cwerner77/MicroSpike/PCB/SpikingNeuron/SpikingNeuron.kicad_pcb

## KiCad design PCB/SpikingNeuron/SpikingNeuron.kicad_pcb (2026-11-09)

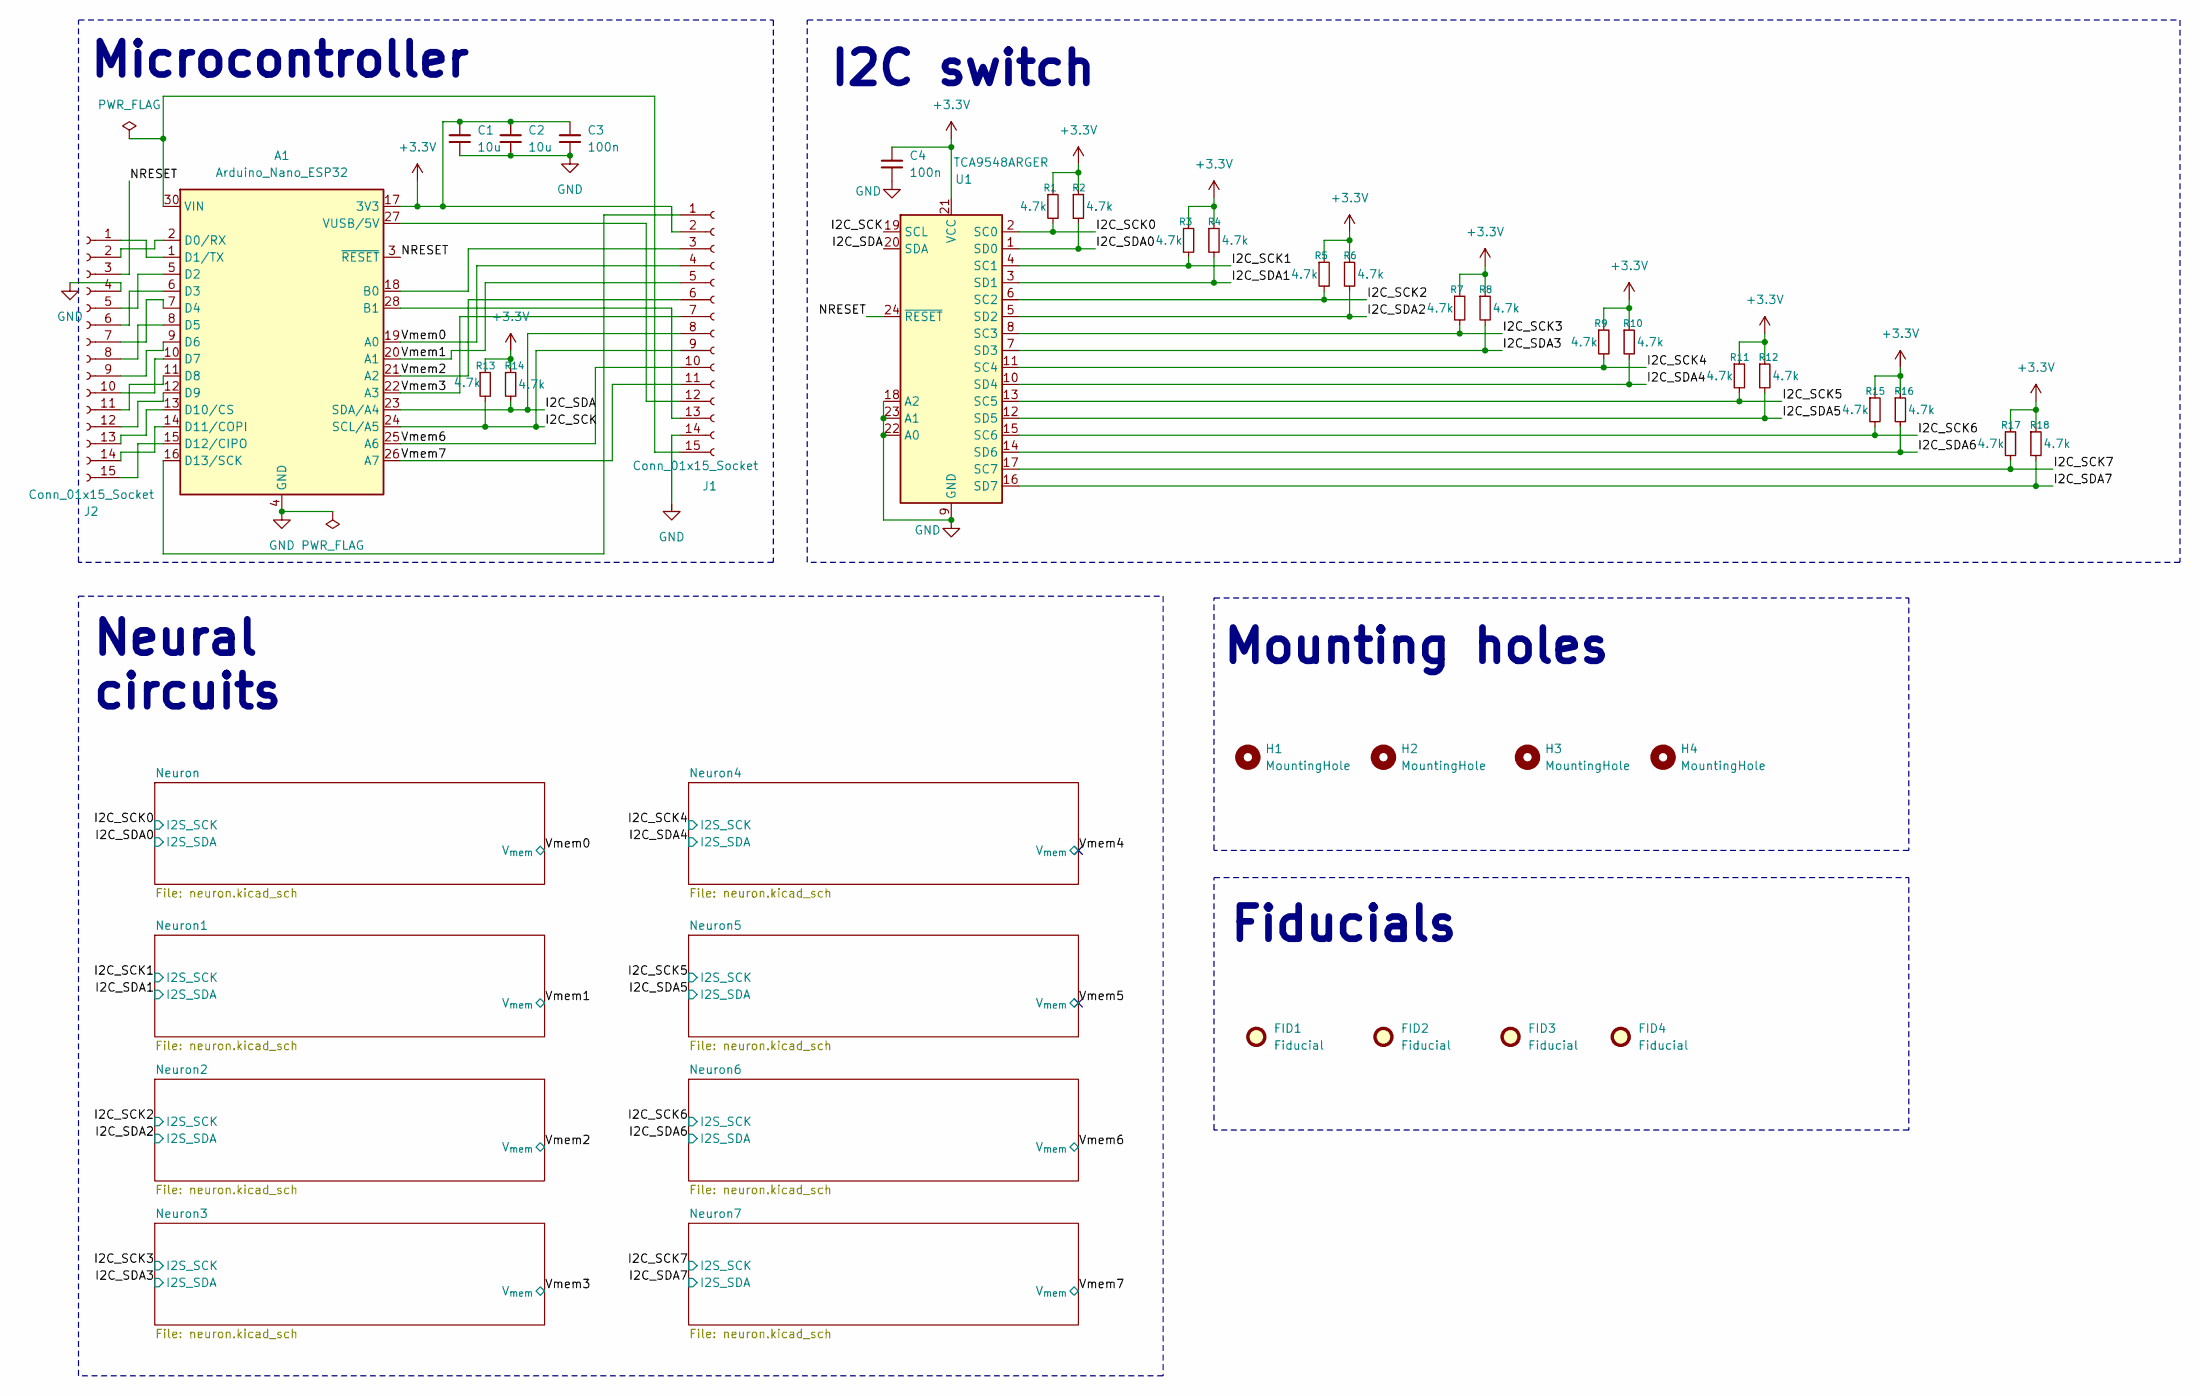
[picture p1: schematic SpikingNeuron.kicad_sch, µSpike]

Parts:
A1: Arduino_Nano_ESP32; Arduino_Nano
C1, C2: 10u; C_0603_1608Metric_Pad1.08x0.95mm_HandSolder
C3, C4: 100n; C_0402_1005Metric_Pad0.74x0.62mm_HandSolder
FID1, FID2, FID3, FID4: Fiducial; Fiducial_0.75mm_Mask1.5mm
H1, H2, H3, H4: MountingHole; MountingHole_3.2mm_M3
J1, J2: Conn_01x15_Socket; PinSocket_1x15_P2.54mm_Vertical
R1, R2, R3, R4, R5, R6, R7, R8, R9, R10, R11, R12, R13, R14, R15, R16, R17, R18: 4.7k; R_0402_1005Metric_Pad0.72x0.64mm_HandSolder
U1: TCA9548ARGER; Texas_RGE0024C_VQFN-24-1EP_4x4mm_P0.5mm_EP2.1x2.1mm

Connections:
+3.3V: A1.17 (3V3), C1.1, C2.1, C3.1, C4.1, J1.2, R1.1, R2.1, R3.1, R4.1, R5.1, R6.1, R7.1, R8.1, R9.1, R10.1, R11.1, R12.1, R13.1, R14.1, R15.1, R16.1, R17.1, R18.1, U1.21 (VCC); also elsewhere on the board
/I2C_SCK: A1.24 (SCL/A5), J1.9, R13.2, U1.19 (SCL)
/I2C_SCK0: R1.2, U1.2 (SC0); also elsewhere on the board
/I2C_SCK1: R3.2, U1.4 (SC1); also elsewhere on the board
/I2C_SCK2: R5.2, U1.6 (SC2); also elsewhere on the board
/I2C_SCK3: R7.2, U1.8 (SC3); also elsewhere on the board
/I2C_SCK4: R9.2, U1.11 (SC4); also elsewhere on the board
/I2C_SCK5: R11.2, U1.13 (SC5); also elsewhere on the board
/I2C_SCK6: R15.2, U1.15 (SC6); also elsewhere on the board
/I2C_SCK7: R17.2, U1.17 (SC7); also elsewhere on the board
/I2C_SDA: A1.23 (SDA/A4), J1.8, R14.2, U1.20 (SDA)
/I2C_SDA0: R2.2, U1.1 (SD0); also elsewhere on the board
/I2C_SDA1: R4.2, U1.3 (SD1); also elsewhere on the board
/I2C_SDA2: R6.2, U1.5 (SD2); also elsewhere on the board
/I2C_SDA3: R8.2, U1.7 (SD3); also elsewhere on the board
/I2C_SDA4: R10.2, U1.10 (SD4); also elsewhere on the board
/I2C_SDA5: R12.2, U1.12 (SD5); also elsewhere on the board
/I2C_SDA6: R16.2, U1.14 (SD6); also elsewhere on the board
/I2C_SDA7: R18.2, U1.16 (SD7); also elsewhere on the board
/NRESET: A1.3 (~RESET), J2.3, U1.24 (~RESET)
/Vmem0: A1.19 (A0), J1.4; also elsewhere on the board
/Vmem1: A1.20 (A1), J1.5; also elsewhere on the board
/Vmem2: A1.21 (A2), J1.6; also elsewhere on the board
/Vmem3: A1.22 (A3), J1.7; also elsewhere on the board
/Vmem6: A1.25 (A6), J1.10; also elsewhere on the board
/Vmem7: A1.26 (A7), J1.11; also elsewhere on the board
GND: A1.4 (GND), A1.29 (GND), C1.2, C2.2, C3.2, C4.2, J1.14, J2.4, U1.9 (GND), U1.18 (A2), U1.22 (A0), U1.23 (A1); also elsewhere on the board
unnamed: A1.18 (B0), J1.3
unnamed: A1.28 (B1), J1.13
unnamed: A1.2 (D0/RX), J2.2
unnamed: A1.1 (D1/TX), J2.1
unnamed: A1.5 (D2), J2.5
unnamed: A1.6 (D3), J2.6
unnamed: A1.7 (D4), J2.7
unnamed: A1.8 (D5), J2.8
unnamed: A1.9 (D6), J2.9
unnamed: A1.10 (D7), J2.10
unnamed: A1.11 (D8), J2.11
unnamed: A1.12 (D9), J2.12
unnamed: A1.13 (D10/CS), J2.13
unnamed: A1.14 (D11/COPI), J2.14
unnamed: A1.15 (D12/CIPO), J2.15
unnamed: A1.16 (D13/SCK), J1.1
unnamed: A1.30 (VIN), J1.15
unnamed: A1.27 (VUSB/5V), J1.12

Notes on the sheet:
I2C switch
Fiducials
Neural circuits
Mounting holes
Microcontroller

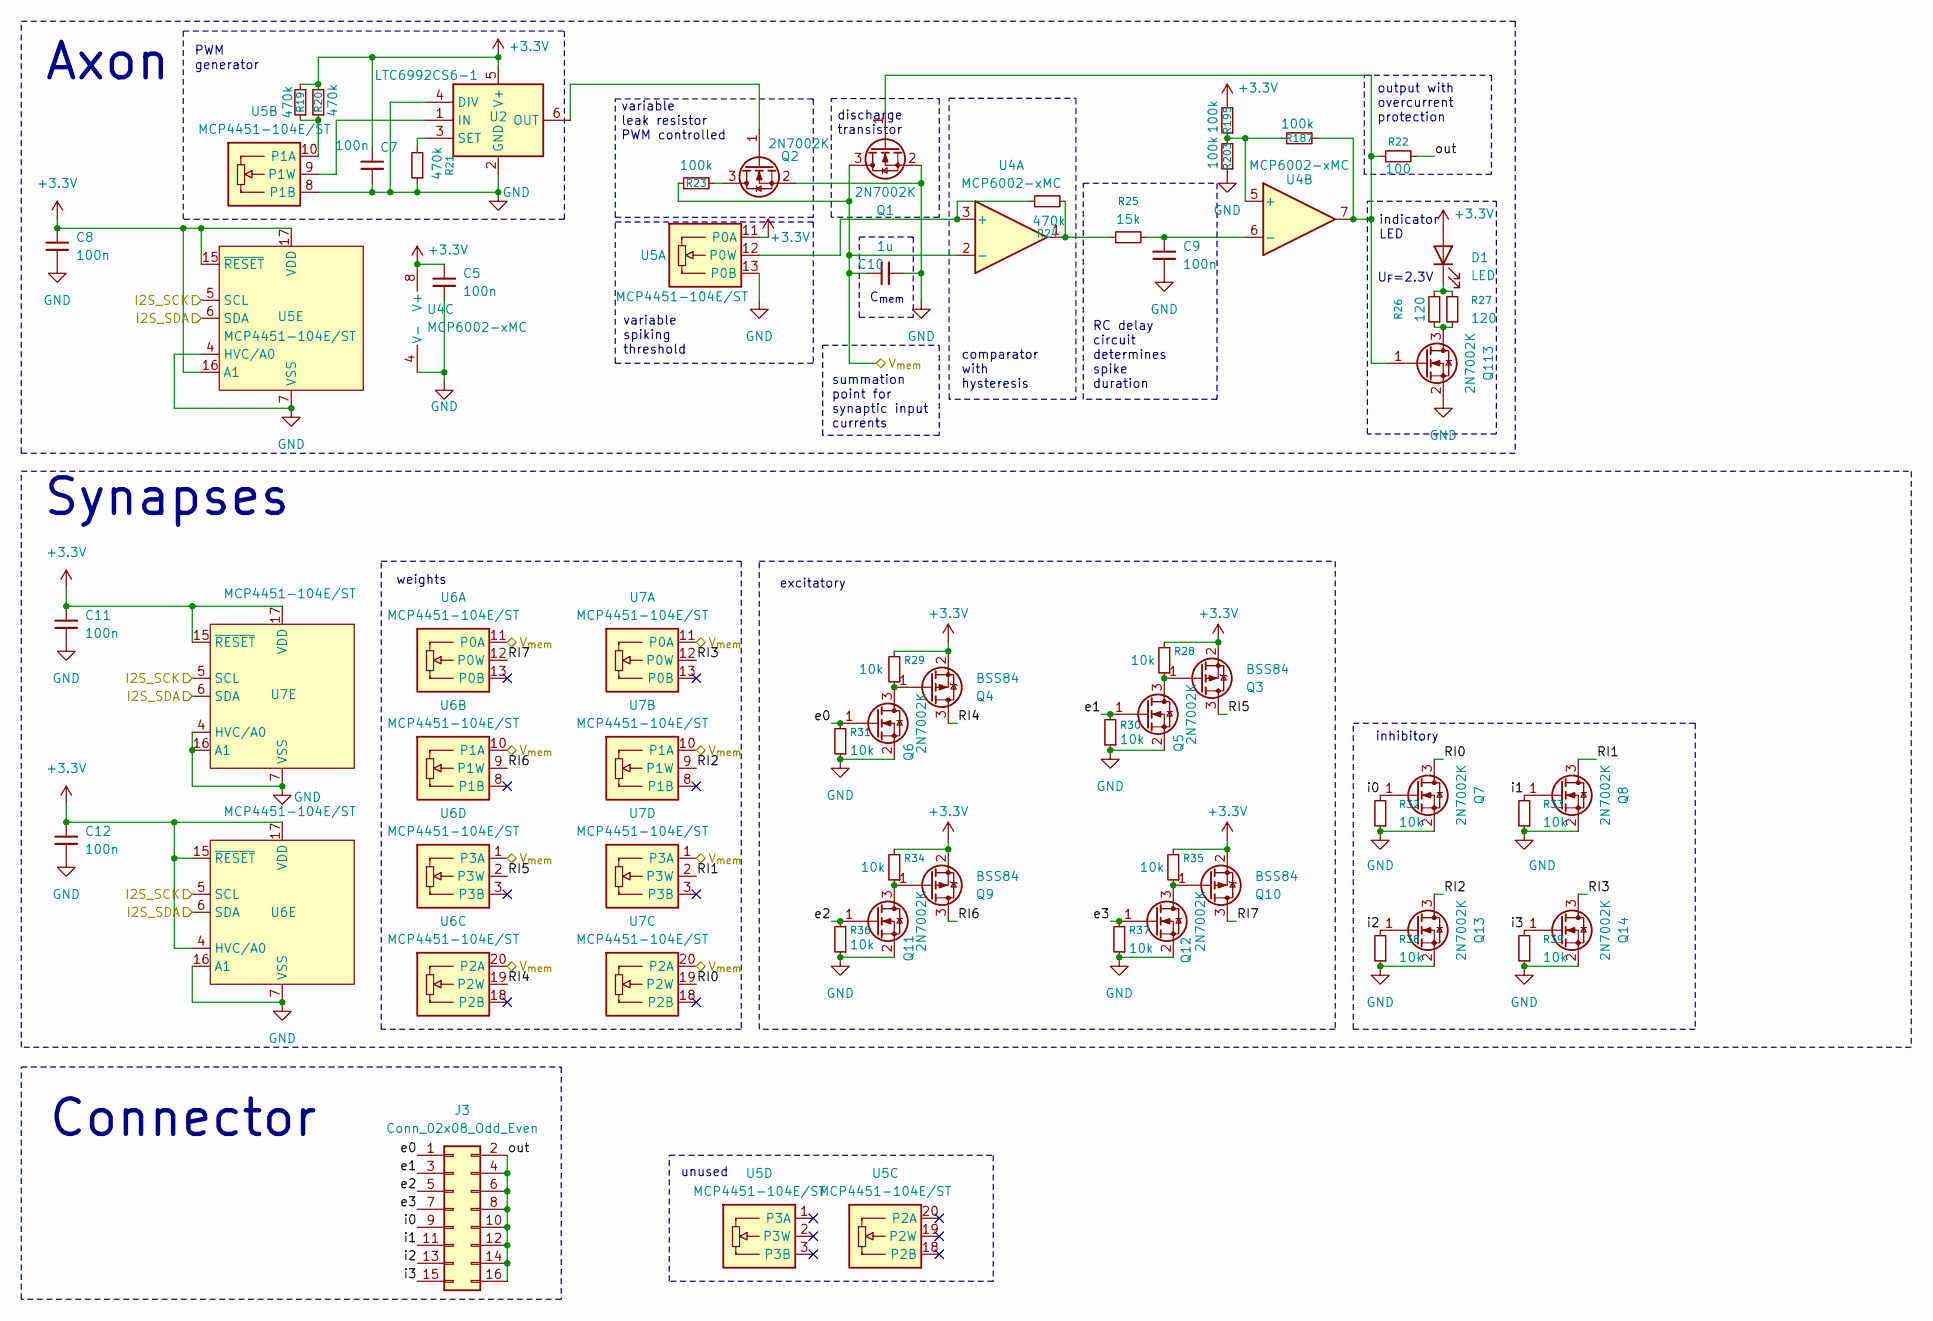
[picture p2: schematic neuron.kicad_sch, µSpike]

Parts:
C5, C7, C8, C9, C11, C12: 100n; C_0402_1005Metric_Pad0.74x0.62mm_HandSolder
C10: 1u; C_0402_1005Metric_Pad0.74x0.62mm_HandSolder
D1: LED; LED_1206_3216Metric_Pad1.42x1.75mm_HandSolder
J3: Conn_02x08_Odd_Even; PinSocket_2x08_P2.54mm_Vertical_SMD
Q1, Q2, Q5, Q6, Q7, Q8, Q11, Q12, Q13, Q14, Q113: 2N7002K; SOT-23
Q3, Q4, Q9, Q10: BSS84; SOT-23
R19, R20, R21, R24: 470k; R_0402_1005Metric_Pad0.72x0.64mm_HandSolder
R22: 100; R_0402_1005Metric_Pad0.72x0.64mm_HandSolder
R23, R187, R195, R203: 100k; R_0402_1005Metric_Pad0.72x0.64mm_HandSolder
R25: 15k; R_0402_1005Metric_Pad0.72x0.64mm_HandSolder
R26, R27: 120; R_0402_1005Metric_Pad0.72x0.64mm_HandSolder
R28, R29, R30, R31, R32, R33, R34, R35, R36, R37, R38, R39: 10k; R_0402_1005Metric_Pad0.72x0.64mm_HandSolder
U2: LTC6992CS6-1; TSOT-23-6
U4: MCP6002-xMC; DFN-8-1EP_3x2mm_P0.5mm_EP1.75x1.45mm
U5, U6, U7: MCP4451-104E/ST; TSSOP-20_4.4x6.5mm_P0.65mm

Connections:
+3.3V: C5.1, C7.1, C8.1, C11.1, C12.1, D1.2 (A), Q3.2 (S), Q4.2 (S), Q9.2 (S), Q10.2 (S), R19.2, R20.2, R28.2, R29.2, R34.2, R35.2, R195.2, U2.5 (V+), U4.8 (V+), U5.11 (P0A), U5.15 (~RESET), U5.16 (A1), U5.17 (VDD), U6.4 (HVC/A0), U6.15 (~RESET), U6.17 (VDD), U7.15 (~RESET), U7.17 (VDD); also elsewhere on the board
/I2C_SCK0: U5.5 (SCL), U6.5 (SCL), U7.5 (SCL); also elsewhere on the board
/I2C_SDA0: U5.6 (SDA), U6.6 (SDA), U7.6 (SDA); also elsewhere on the board
/Neuron/RI0: Q7.3 (D), U7.19 (P2W)
/Neuron/RI1: Q8.3 (D), U7.2 (P3W)
/Neuron/RI2: Q13.3 (D), U7.9 (P1W)
/Neuron/RI3: Q14.3 (D), U7.12 (P0W)
/Neuron/RI4: Q4.3 (D), U6.19 (P2W)
/Neuron/RI5: Q3.3 (D), U6.2 (P3W)
/Neuron/RI6: Q9.3 (D), U6.9 (P1W)
/Neuron/RI7: Q10.3 (D), U6.12 (P0W)
/Neuron/e0: J3.1, Q6.1 (G), R31.2
/Neuron/e1: J3.3, Q5.1 (G), R30.2
/Neuron/e2: J3.5, Q11.1 (G), R36.2
/Neuron/e3: J3.7, Q12.1 (G), R37.2
/Neuron/i0: J3.9, Q7.1 (G), R32.2
/Neuron/i1: J3.11, Q8.1 (G), R33.2
/Neuron/i2: J3.13, Q13.1 (G), R38.2
/Neuron/i3: J3.15, Q14.1 (G), R39.2
/Neuron/out: J3.2, J3.4, J3.6, J3.8, J3.10, J3.12, J3.14, J3.16, R22.2
/Vmem0: C10.1, Q1.3 (D), R23.1, U4.2 (-), U6.1 (P3A), U6.10 (P1A), U6.11 (P0A), U6.20 (P2A), U7.1 (P3A), U7.10 (P1A), U7.11 (P0A), U7.20 (P2A); also elsewhere on the board
GND: C5.2, C7.2, C8.2, C9.1, C10.2, C11.2, C12.2, Q1.2 (S), Q2.2 (S), Q5.2 (S), Q6.2 (S), Q7.2 (S), Q8.2 (S), Q11.2 (S), Q12.2 (S), Q13.2 (S), Q14.2 (S), Q113.2 (S), R21.1, R30.1, R31.1, R32.1, R33.1, R36.1, R37.1, R38.1, R39.1, R203.1, U2.2 (GND), U2.4 (DIV), U4.4 (V-), U4.9 (V-), U5.4 (HVC/A0), U5.7 (VSS), U5.8 (P1B), U5.13 (P0B), U6.7 (VSS), U6.16 (A1), U7.4 (HVC/A0), U7.7 (VSS), U7.16 (A1); also elsewhere on the board
unnamed: D1.1 (K), R26.2, R27.2
unnamed: Q1.1 (G), Q113.1 (G), R22.1, R187.2, U4.7
unnamed: Q2.3 (D), R23.2
unnamed: Q2.1 (G), U2.6 (OUT)
unnamed: Q3.1 (G), Q5.3 (D), R28.1
unnamed: Q4.1 (G), Q6.3 (D), R29.1
unnamed: Q10.1 (G), Q12.3 (D), R35.1
unnamed: Q9.1 (G), Q11.3 (D), R34.1
unnamed: Q113.3 (D), R26.1, R27.1
unnamed: R24.2, R25.1, U4.1
unnamed: U2.1 (IN), U5.9 (P1W)
unnamed: R21.2, U2.3 (SET)
unnamed: R24.1, U4.3 (+), U5.12 (P0W)
unnamed: R187.1, R195.1, R203.2, U4.5 (+)
unnamed: C9.2, R25.2, U4.6 (-)
unnamed: R19.1, R20.1, U5.10 (P1A)

Parts of its further copies:
C13, C15, C16, C17, C19, C20, C21, C23, C24, C25, C27, C28, C29, C31, C32, C33, C35, C36, C37, C39, C40, C41, C43, C44, C45, C47, C48, C49, C51, C52, C53, C55, C56, C57, C59, C60, C61, C63, C64, C65, C67, C68: 100n; C_0402_1005Metric_Pad0.74x0.62mm_HandSolder
C18, C26, C34, C42, C50, C58, C66: 1u; C_0402_1005Metric_Pad0.74x0.62mm_HandSolder
D2, D3, D4, D5, D6, D7, D8: LED; LED_1206_3216Metric_Pad1.42x1.75mm_HandSolder
J4, J5, J6, J7, J8, J9, J10: Conn_02x08_Odd_Even; PinSocket_2x08_P2.54mm_Vertical_SMD
Q15, Q16, Q19, Q20, Q21, Q22, Q25, Q26, Q27, Q28, Q29, Q30, Q33, Q34, Q35, Q36, Q39, Q40, Q41, Q42, Q43, Q44, Q47, Q48, Q49, Q50, Q53, Q54, Q55, Q56, Q57, Q58, Q61, Q62, Q63, Q64, Q67, Q68, Q69, Q70, Q71, Q72, Q75, Q76, Q77, Q78, Q81, Q82, Q83, Q84, Q85, Q86, Q89, Q90, Q91, Q92, Q95, Q96, Q97, Q98, Q99, Q100, Q103, Q104, Q105, Q106, Q109, Q110, Q111, Q112, Q114, Q115, Q116, Q117, Q118, Q119, Q120: 2N7002K; SOT-23
Q17, Q18, Q23, Q24, Q31, Q32, Q37, Q38, Q45, Q46, Q51, Q52, Q59, Q60, Q65, Q66, Q73, Q74, Q79, Q80, Q87, Q88, Q93, Q94, Q101, Q102, Q107, Q108: BSS84; SOT-23
R40, R41, R42, R45, R61, R62, R63, R66, R82, R83, R84, R87, R103, R104, R105, R108, R124, R125, R126, R129, R145, R146, R147, R150, R166, R167, R168, R171: 470k; R_0402_1005Metric_Pad0.72x0.64mm_HandSolder
R43, R64, R85, R106, R127, R148, R169: 100; R_0402_1005Metric_Pad0.72x0.64mm_HandSolder
R44, R65, R86, R107, R128, R149, R170, R188, R189, R190, R191, R192, R193, R194, R196, R197, R198, R199, R200, R201, R202, R204, R205, R206, R207, R208, R209, R210: 100k; R_0402_1005Metric_Pad0.72x0.64mm_HandSolder
R46, R67, R88, R109, R130, R151, R172: 15k; R_0402_1005Metric_Pad0.72x0.64mm_HandSolder
R47, R48, R68, R69, R89, R90, R110, R111, R131, R132, R152, R153, R173, R174: 120; R_0402_1005Metric_Pad0.72x0.64mm_HandSolder
R49, R50, R51, R52, R53, R54, R55, R56, R57, R58, R59, R60, R70, R71, R72, R73, R74, R75, R76, R77, R78, R79, R80, R81, R91, R92, R93, R94, R95, R96, R97, R98, R99, R100, R101, R102, R112, R113, R114, R115, R116, R117, R118, R119, R120, R121, R122, R123, R133, R134, R135, R136, R137, R138, R139, R140, R141, R142, R143, R144, R154, R155, R156, R157, R158, R159, R160, R161, R162, R163, R164, R165, R175, R176, R177, R178, R179, R180, R181, R182, R183, R184, R185, R186: 10k; R_0402_1005Metric_Pad0.72x0.64mm_HandSolder
U8, U15, U22, U29, U36, U43, U50: LTC6992CS6-1; TSOT-23-6
U10, U17, U24, U31, U38, U45, U52: MCP6002-xMC; DFN-8-1EP_3x2mm_P0.5mm_EP1.75x1.45mm
U11, U12, U13, U14, U18, U19, U20, U21, U25, U26, U27, U28, U32, U34, U35, U41, U42, U48, U49, U55, U56: MCP4451-104E/ST; TSSOP-20_4.4x6.5mm_P0.65mm

Connections of its further copies:
+3.3V: C13.1, C15.1, C16.1, C19.1, C20.1, C21.1, C23.1, C24.1, C27.1, C28.1, C29.1, C31.1, C32.1, C35.1, C36.1, C37.1, C39.1, C40.1, C43.1, C44.1, C45.1, C47.1, C48.1, C51.1, C52.1, C53.1, C55.1, C56.1, C59.1, C60.1, C61.1, C63.1, C64.1, C67.1, C68.1, D2.2 (A), D3.2 (A), D4.2 (A), D5.2 (A), D6.2 (A), D7.2 (A), D8.2 (A), Q17.2 (S), Q18.2 (S), Q23.2 (S), Q24.2 (S), Q31.2 (S), Q32.2 (S), Q37.2 (S), Q38.2 (S), Q45.2 (S), Q46.2 (S), Q51.2 (S), Q52.2 (S), Q59.2 (S), Q60.2 (S), Q65.2 (S), Q66.2 (S), Q73.2 (S), Q74.2 (S), Q79.2 (S), Q80.2 (S), Q87.2 (S), Q88.2 (S), Q93.2 (S), Q94.2 (S), Q101.2 (S), Q102.2 (S), Q107.2 (S), Q108.2 (S), R40.2, R41.2, R49.2, R50.2, R55.2, R56.2, R61.2, R62.2, R70.2, R71.2, R76.2, R77.2, R82.2, R83.2, R91.2, R92.2, R97.2, R98.2, R103.2, R104.2, R112.2, R113.2, R118.2, R119.2, R124.2, R125.2, R133.2, R134.2, R139.2, R140.2, R145.2, R146.2, R154.2, R155.2, R160.2, R161.2, R166.2, R167.2, R175.2, R176.2, R181.2, R182.2, R196.2, R197.2, R198.2, R199.2, R200.2, R201.2, R202.2, U8.5 (V+), U10.8 (V+), U11.11 (P0A), U11.15 (~RESET), U11.16 (A1), U11.17 (VDD), U12.11 (P0A), U12.15 (~RESET), U12.16 (A1), U12.17 (VDD), U13.4 (HVC/A0), U13.15 (~RESET), U13.17 (VDD), U14.15 (~RESET), U14.17 (VDD), U15.5 (V+), U17.8 (V+), U18.11 (P0A), U18.15 (~RESET), U18.16 (A1), U18.17 (VDD), U19.11 (P0A), U19.15 (~RESET), U19.16 (A1), U19.17 (VDD), U20.4 (HVC/A0), U20.15 (~RESET), U20.17 (VDD), U21.15 (~RESET), U21.17 (VDD), U22.5 (V+), U24.8 (V+), U25.11 (P0A), U25.15 (~RESET), U25.16 (A1), U25.17 (VDD), U26.11 (P0A), U26.15 (~RESET), U26.16 (A1), U26.17 (VDD), U27.4 (HVC/A0), U27.15 (~RESET), U27.17 (VDD), U28.15 (~RESET), U28.17 (VDD), U29.5 (V+), U31.8 (V+), U32.11 (P0A), U32.15 (~RESET), U32.16 (A1), U32.17 (VDD), U34.4 (HVC/A0), U34.15 (~RESET), U34.17 (VDD), U35.15 (~RESET), U35.17 (VDD), U36.5 (V+), U38.8 (V+), U41.4 (HVC/A0), U41.15 (~RESET), U41.17 (VDD), U42.15 (~RESET), U42.17 (VDD), U43.5 (V+), U45.8 (V+), U48.4 (HVC/A0), U48.15 (~RESET), U48.17 (VDD), U49.15 (~RESET), U49.17 (VDD), U50.5 (V+), U52.8 (V+), U55.4 (HVC/A0), U55.15 (~RESET), U55.17 (VDD), U56.15 (~RESET), U56.17 (VDD); also elsewhere on the board
/I2C_SCK1: U11.5 (SCL), U13.5 (SCL), U14.5 (SCL); also elsewhere on the board
/I2C_SCK2: U12.5 (SCL), U20.5 (SCL), U21.5 (SCL); also elsewhere on the board
/I2C_SCK3: U18.5 (SCL), U27.5 (SCL), U28.5 (SCL); also elsewhere on the board
/I2C_SCK4: U19.5 (SCL), U34.5 (SCL), U35.5 (SCL); also elsewhere on the board
/I2C_SCK5: U25.5 (SCL), U41.5 (SCL), U42.5 (SCL); also elsewhere on the board
/I2C_SCK6: U26.5 (SCL), U48.5 (SCL), U49.5 (SCL); also elsewhere on the board
/I2C_SCK7: U32.5 (SCL), U55.5 (SCL), U56.5 (SCL); also elsewhere on the board
/I2C_SDA1: U11.6 (SDA), U13.6 (SDA), U14.6 (SDA); also elsewhere on the board
/I2C_SDA2: U12.6 (SDA), U20.6 (SDA), U21.6 (SDA); also elsewhere on the board
/I2C_SDA3: U18.6 (SDA), U27.6 (SDA), U28.6 (SDA); also elsewhere on the board
/I2C_SDA4: U19.6 (SDA), U34.6 (SDA), U35.6 (SDA); also elsewhere on the board
/I2C_SDA5: U25.6 (SDA), U41.6 (SDA), U42.6 (SDA); also elsewhere on the board
/I2C_SDA6: U26.6 (SDA), U48.6 (SDA), U49.6 (SDA); also elsewhere on the board
/I2C_SDA7: U32.6 (SDA), U55.6 (SDA), U56.6 (SDA); also elsewhere on the board
/Neuron1/RI0: Q21.3 (D), U14.19 (P2W)
/Neuron1/RI1: Q22.3 (D), U14.2 (P3W)
/Neuron1/RI2: Q27.3 (D), U14.9 (P1W)
/Neuron1/RI3: Q28.3 (D), U14.12 (P0W)
/Neuron1/RI4: Q18.3 (D), U13.19 (P2W)
/Neuron1/RI5: Q17.3 (D), U13.2 (P3W)
/Neuron1/RI6: Q23.3 (D), U13.9 (P1W)
/Neuron1/RI7: Q24.3 (D), U13.12 (P0W)
/Neuron1/e0: J4.1, Q20.1 (G), R52.2
/Neuron1/e1: J4.3, Q19.1 (G), R51.2
/Neuron1/e2: J4.5, Q25.1 (G), R57.2
/Neuron1/e3: J4.7, Q26.1 (G), R58.2
/Neuron1/i0: J4.9, Q21.1 (G), R53.2
/Neuron1/i1: J4.11, Q22.1 (G), R54.2
/Neuron1/i2: J4.13, Q27.1 (G), R59.2
/Neuron1/i3: J4.15, Q28.1 (G), R60.2
/Neuron1/out: J4.2, J4.4, J4.6, J4.8, J4.10, J4.12, J4.14, J4.16, R43.2
/Neuron2/RI0: Q35.3 (D), U21.19 (P2W)
/Neuron2/RI1: Q36.3 (D), U21.2 (P3W)
/Neuron2/RI2: Q41.3 (D), U21.9 (P1W)
/Neuron2/RI3: Q42.3 (D), U21.12 (P0W)
/Neuron2/RI4: Q32.3 (D), U20.19 (P2W)
/Neuron2/RI5: Q31.3 (D), U20.2 (P3W)
/Neuron2/RI6: Q37.3 (D), U20.9 (P1W)
/Neuron2/RI7: Q38.3 (D), U20.12 (P0W)
/Neuron2/e0: J5.1, Q34.1 (G), R73.2
/Neuron2/e1: J5.3, Q33.1 (G), R72.2
/Neuron2/e2: J5.5, Q39.1 (G), R78.2
/Neuron2/e3: J5.7, Q40.1 (G), R79.2
/Neuron2/i0: J5.9, Q35.1 (G), R74.2
/Neuron2/i1: J5.11, Q36.1 (G), R75.2
/Neuron2/i2: J5.13, Q41.1 (G), R80.2
/Neuron2/i3: J5.15, Q42.1 (G), R81.2
/Neuron2/out: J5.2, J5.4, J5.6, J5.8, J5.10, J5.12, J5.14, J5.16, R64.2
/Neuron3/RI0: Q49.3 (D), U28.19 (P2W)
/Neuron3/RI1: Q50.3 (D), U28.2 (P3W)
/Neuron3/RI2: Q55.3 (D), U28.9 (P1W)
/Neuron3/RI3: Q56.3 (D), U28.12 (P0W)
/Neuron3/RI4: Q46.3 (D), U27.19 (P2W)
/Neuron3/RI5: Q45.3 (D), U27.2 (P3W)
/Neuron3/RI6: Q51.3 (D), U27.9 (P1W)
/Neuron3/RI7: Q52.3 (D), U27.12 (P0W)
/Neuron3/e0: J6.1, Q48.1 (G), R94.2
/Neuron3/e1: J6.3, Q47.1 (G), R93.2
/Neuron3/e2: J6.5, Q53.1 (G), R99.2
/Neuron3/e3: J6.7, Q54.1 (G), R100.2
/Neuron3/i0: J6.9, Q49.1 (G), R95.2
/Neuron3/i1: J6.11, Q50.1 (G), R96.2
/Neuron3/i2: J6.13, Q55.1 (G), R101.2
/Neuron3/i3: J6.15, Q56.1 (G), R102.2
/Neuron3/out: J6.2, J6.4, J6.6, J6.8, J6.10, J6.12, J6.14, J6.16, R85.2
/Neuron4/RI0: Q63.3 (D), U35.19 (P2W)
/Neuron4/RI1: Q64.3 (D), U35.2 (P3W)
/Neuron4/RI2: Q69.3 (D), U35.9 (P1W)
/Neuron4/RI3: Q70.3 (D), U35.12 (P0W)
/Neuron4/RI4: Q60.3 (D), U34.19 (P2W)
/Neuron4/RI5: Q59.3 (D), U34.2 (P3W)
/Neuron4/RI6: Q65.3 (D), U34.9 (P1W)
/Neuron4/RI7: Q66.3 (D), U34.12 (P0W)
/Neuron4/e0: J7.1, Q62.1 (G), R115.2
/Neuron4/e1: J7.3, Q61.1 (G), R114.2
/Neuron4/e2: J7.5, Q67.1 (G), R120.2
/Neuron4/e3: J7.7, Q68.1 (G), R121.2
/Neuron4/i0: J7.9, Q63.1 (G), R116.2
/Neuron4/i1: J7.11, Q64.1 (G), R117.2
/Neuron4/i2: J7.13, Q69.1 (G), R122.2
/Neuron4/i3: J7.15, Q70.1 (G), R123.2
/Neuron4/out: J7.2, J7.4, J7.6, J7.8, J7.10, J7.12, J7.14, J7.16, R106.2
/Neuron5/RI0: Q77.3 (D), U42.19 (P2W)
/Neuron5/RI1: Q78.3 (D), U42.2 (P3W)
/Neuron5/RI2: Q83.3 (D), U42.9 (P1W)
/Neuron5/RI3: Q84.3 (D), U42.12 (P0W)
/Neuron5/RI4: Q74.3 (D), U41.19 (P2W)
/Neuron5/RI5: Q73.3 (D), U41.2 (P3W)
/Neuron5/RI6: Q79.3 (D), U41.9 (P1W)
/Neuron5/RI7: Q80.3 (D), U41.12 (P0W)
/Neuron5/e0: J8.1, Q76.1 (G), R136.2
/Neuron5/e1: J8.3, Q75.1 (G), R135.2
/Neuron5/e2: J8.5, Q81.1 (G), R141.2
/Neuron5/e3: J8.7, Q82.1 (G), R142.2
/Neuron5/i0: J8.9, Q77.1 (G), R137.2
/Neuron5/i1: J8.11, Q78.1 (G), R138.2
/Neuron5/i2: J8.13, Q83.1 (G), R143.2
/Neuron5/i3: J8.15, Q84.1 (G), R144.2
/Neuron5/out: J8.2, J8.4, J8.6, J8.8, J8.10, J8.12, J8.14, J8.16, R127.2
/Neuron6/RI0: Q91.3 (D), U49.19 (P2W)
/Neuron6/RI1: Q92.3 (D), U49.2 (P3W)
/Neuron6/RI2: Q97.3 (D), U49.9 (P1W)
/Neuron6/RI3: Q98.3 (D), U49.12 (P0W)
/Neuron6/RI4: Q88.3 (D), U48.19 (P2W)
/Neuron6/RI5: Q87.3 (D), U48.2 (P3W)
/Neuron6/RI6: Q93.3 (D), U48.9 (P1W)
/Neuron6/RI7: Q94.3 (D), U48.12 (P0W)
/Neuron6/e0: J9.1, Q90.1 (G), R157.2
/Neuron6/e1: J9.3, Q89.1 (G), R156.2
/Neuron6/e2: J9.5, Q95.1 (G), R162.2
/Neuron6/e3: J9.7, Q96.1 (G), R163.2
/Neuron6/i0: J9.9, Q91.1 (G), R158.2
/Neuron6/i1: J9.11, Q92.1 (G), R159.2
/Neuron6/i2: J9.13, Q97.1 (G), R164.2
/Neuron6/i3: J9.15, Q98.1 (G), R165.2
/Neuron6/out: J9.2, J9.4, J9.6, J9.8, J9.10, J9.12, J9.14, J9.16, R148.2
/Neuron7/RI0: Q105.3 (D), U56.19 (P2W)
/Neuron7/RI1: Q106.3 (D), U56.2 (P3W)
/Neuron7/RI2: Q111.3 (D), U56.9 (P1W)
/Neuron7/RI3: Q112.3 (D), U56.12 (P0W)
/Neuron7/RI4: Q102.3 (D), U55.19 (P2W)
/Neuron7/RI5: Q101.3 (D), U55.2 (P3W)
/Neuron7/RI6: Q107.3 (D), U55.9 (P1W)
/Neuron7/RI7: Q108.3 (D), U55.12 (P0W)
/Neuron7/e0: J10.1, Q104.1 (G), R178.2
/Neuron7/e1: J10.3, Q103.1 (G), R177.2
/Neuron7/e2: J10.5, Q109.1 (G), R183.2
/Neuron7/e3: J10.7, Q110.1 (G), R184.2
/Neuron7/i0: J10.9, Q105.1 (G), R179.2
/Neuron7/i1: J10.11, Q106.1 (G), R180.2
/Neuron7/i2: J10.13, Q111.1 (G), R185.2
/Neuron7/i3: J10.15, Q112.1 (G), R186.2
/Neuron7/out: J10.2, J10.4, J10.6, J10.8, J10.10, J10.12, J10.14, J10.16, R169.2
/Vmem1: C18.1, Q15.3 (D), R44.1, U10.2 (-), U13.1 (P3A), U13.10 (P1A), U13.11 (P0A), U13.20 (P2A), U14.1 (P3A), U14.10 (P1A), U14.11 (P0A), U14.20 (P2A); also elsewhere on the board
/Vmem2: C26.1, Q29.3 (D), R65.1, U17.2 (-), U20.1 (P3A), U20.10 (P1A), U20.11 (P0A), U20.20 (P2A), U21.1 (P3A), U21.10 (P1A), U21.11 (P0A), U21.20 (P2A); also elsewhere on the board
/Vmem3: C34.1, Q43.3 (D), R86.1, U24.2 (-), U27.1 (P3A), U27.10 (P1A), U27.11 (P0A), U27.20 (P2A), U28.1 (P3A), U28.10 (P1A), U28.11 (P0A), U28.20 (P2A); also elsewhere on the board
/Vmem4: C42.1, Q57.3 (D), R107.1, U31.2 (-), U34.1 (P3A), U34.10 (P1A), U34.11 (P0A), U34.20 (P2A), U35.1 (P3A), U35.10 (P1A), U35.11 (P0A), U35.20 (P2A)
/Vmem5: C50.1, Q71.3 (D), R128.1, U38.2 (-), U41.1 (P3A), U41.10 (P1A), U41.11 (P0A), U41.20 (P2A), U42.1 (P3A), U42.10 (P1A), U42.11 (P0A), U42.20 (P2A)
/Vmem6: C58.1, Q85.3 (D), R149.1, U45.2 (-), U48.1 (P3A), U48.10 (P1A), U48.11 (P0A), U48.20 (P2A), U49.1 (P3A), U49.10 (P1A), U49.11 (P0A), U49.20 (P2A); also elsewhere on the board
/Vmem7: C66.1, Q99.3 (D), R170.1, U52.2 (-), U55.1 (P3A), U55.10 (P1A), U55.11 (P0A), U55.20 (P2A), U56.1 (P3A), U56.10 (P1A), U56.11 (P0A), U56.20 (P2A); also elsewhere on the board
GND: C13.2, C15.2, C16.2, C17.1, C18.2, C19.2, C20.2, C21.2, C23.2, C24.2, C25.1, C26.2, C27.2, C28.2, C29.2, C31.2, C32.2, C33.1, C34.2, C35.2, C36.2, C37.2, C39.2, C40.2, C41.1, C42.2, C43.2, C44.2, C45.2, C47.2, C48.2, C49.1, C50.2, C51.2, C52.2, C53.2, C55.2, C56.2, C57.1, C58.2, C59.2, C60.2, C61.2, C63.2, C64.2, C65.1, C66.2, C67.2, C68.2, Q15.2 (S), Q16.2 (S), Q19.2 (S), Q20.2 (S), Q21.2 (S), Q22.2 (S), Q25.2 (S), Q26.2 (S), Q27.2 (S), Q28.2 (S), Q29.2 (S), Q30.2 (S), Q33.2 (S), Q34.2 (S), Q35.2 (S), Q36.2 (S), Q39.2 (S), Q40.2 (S), Q41.2 (S), Q42.2 (S), Q43.2 (S), Q44.2 (S), Q47.2 (S), Q48.2 (S), Q49.2 (S), Q50.2 (S), Q53.2 (S), Q54.2 (S), Q55.2 (S), Q56.2 (S), Q57.2 (S), Q58.2 (S), Q61.2 (S), Q62.2 (S), Q63.2 (S), Q64.2 (S), Q67.2 (S), Q68.2 (S), Q69.2 (S), Q70.2 (S), Q71.2 (S), Q72.2 (S), Q75.2 (S), Q76.2 (S), Q77.2 (S), Q78.2 (S), Q81.2 (S), Q82.2 (S), Q83.2 (S), Q84.2 (S), Q85.2 (S), Q86.2 (S), Q89.2 (S), Q90.2 (S), Q91.2 (S), Q92.2 (S), Q95.2 (S), Q96.2 (S), Q97.2 (S), Q98.2 (S), Q99.2 (S), Q100.2 (S), Q103.2 (S), Q104.2 (S), Q105.2 (S), Q106.2 (S), Q109.2 (S), Q110.2 (S), Q111.2 (S), Q112.2 (S), Q114.2 (S), Q115.2 (S), Q116.2 (S), Q117.2 (S), Q118.2 (S), Q119.2 (S), Q120.2 (S), R42.1, R51.1, R52.1, R53.1, R54.1, R57.1, R58.1, R59.1, R60.1, R63.1, R72.1, R73.1, R74.1, R75.1, R78.1, R79.1, R80.1, R81.1, R84.1, R93.1, R94.1, R95.1, R96.1, R99.1, R100.1, R101.1, R102.1, R105.1, R114.1, R115.1, R116.1, R117.1, R120.1, R121.1, R122.1, R123.1, R126.1, R135.1, R136.1, R137.1, R138.1, R141.1, R142.1, R143.1, R144.1, R147.1, R156.1, R157.1, R158.1, R159.1, R162.1, R163.1, R164.1, R165.1, R168.1, R177.1, R178.1, R179.1, R180.1, R183.1, R184.1, R185.1, R186.1, R204.1, R205.1, R206.1, R207.1, R208.1, R209.1, R210.1, U8.2 (GND), U8.4 (DIV), U10.4 (V-), U10.9 (V-), U11.4 (HVC/A0), U11.7 (VSS), U11.8 (P1B), U11.13 (P0B), U12.4 (HVC/A0), U12.7 (VSS), U12.8 (P1B), U12.13 (P0B), U13.7 (VSS), U13.16 (A1), U14.4 (HVC/A0), U14.7 (VSS), U14.16 (A1), U15.2 (GND), U15.4 (DIV), U17.4 (V-), U17.9 (V-), U18.4 (HVC/A0), U18.7 (VSS), U18.8 (P1B), U18.13 (P0B), U19.4 (HVC/A0), U19.7 (VSS), U19.8 (P1B), U19.13 (P0B), U20.7 (VSS), U20.16 (A1), U21.4 (HVC/A0), U21.7 (VSS), U21.16 (A1), U22.2 (GND), U22.4 (DIV), U24.4 (V-), U24.9 (V-), U25.4 (HVC/A0), U25.7 (VSS), U25.8 (P1B), U25.13 (P0B), U26.4 (HVC/A0), U26.7 (VSS), U26.8 (P1B), U26.13 (P0B), U27.7 (VSS), U27.16 (A1), U28.4 (HVC/A0), U28.7 (VSS), U28.16 (A1), U29.2 (GND), U29.4 (DIV), U31.4 (V-), U31.9 (V-), U32.4 (HVC/A0), U32.7 (VSS), U32.8 (P1B), U32.13 (P0B), U34.7 (VSS), U34.16 (A1), U35.4 (HVC/A0), U35.7 (VSS), U35.16 (A1), U36.2 (GND), U36.4 (DIV), U38.4 (V-), U38.9 (V-), U41.7 (VSS), U41.16 (A1), U42.4 (HVC/A0), U42.7 (VSS), U42.16 (A1), U43.2 (GND), U43.4 (DIV), U45.4 (V-), U45.9 (V-), U48.7 (VSS), U48.16 (A1), U49.4 (HVC/A0), U49.7 (VSS), U49.16 (A1), U50.2 (GND), U50.4 (DIV), U52.4 (V-), U52.9 (V-), U55.7 (VSS), U55.16 (A1), U56.4 (HVC/A0), U56.7 (VSS), U56.16 (A1); also elsewhere on the board
unnamed: D2.1 (K), R47.2, R48.2
unnamed: D3.1 (K), R68.2, R69.2
unnamed: D4.1 (K), R89.2, R90.2
unnamed: D5.1 (K), R110.2, R111.2
unnamed: D6.1 (K), R131.2, R132.2
unnamed: D7.1 (K), R152.2, R153.2
unnamed: D8.1 (K), R173.2, R174.2
unnamed: Q16.3 (D), R44.2
unnamed: Q16.1 (G), U8.6 (OUT)
unnamed: Q17.1 (G), Q19.3 (D), R49.1
unnamed: Q18.1 (G), Q20.3 (D), R50.1
unnamed: Q23.1 (G), Q25.3 (D), R55.1
unnamed: Q24.1 (G), Q26.3 (D), R56.1
unnamed: Q30.3 (D), R65.2
unnamed: Q30.1 (G), U15.6 (OUT)
unnamed: Q31.1 (G), Q33.3 (D), R70.1
unnamed: Q32.1 (G), Q34.3 (D), R71.1
unnamed: Q37.1 (G), Q39.3 (D), R76.1
unnamed: Q38.1 (G), Q40.3 (D), R77.1
unnamed: Q44.3 (D), R86.2
unnamed: Q44.1 (G), U22.6 (OUT)
unnamed: Q45.1 (G), Q47.3 (D), R91.1
unnamed: Q46.1 (G), Q48.3 (D), R92.1
unnamed: Q51.1 (G), Q53.3 (D), R97.1
unnamed: Q52.1 (G), Q54.3 (D), R98.1
unnamed: Q58.3 (D), R107.2
unnamed: Q58.1 (G), U29.6 (OUT)
unnamed: Q59.1 (G), Q61.3 (D), R112.1
unnamed: Q60.1 (G), Q62.3 (D), R113.1
unnamed: Q65.1 (G), Q67.3 (D), R118.1
unnamed: Q66.1 (G), Q68.3 (D), R119.1
unnamed: Q72.3 (D), R128.2
unnamed: Q72.1 (G), U36.6 (OUT)
unnamed: Q73.1 (G), Q75.3 (D), R133.1
unnamed: Q74.1 (G), Q76.3 (D), R134.1
unnamed: Q79.1 (G), Q81.3 (D), R139.1
unnamed: Q80.1 (G), Q82.3 (D), R140.1
unnamed: Q86.3 (D), R149.2
unnamed: Q86.1 (G), U43.6 (OUT)
unnamed: Q87.1 (G), Q89.3 (D), R154.1
unnamed: Q88.1 (G), Q90.3 (D), R155.1
unnamed: Q93.1 (G), Q95.3 (D), R160.1
unnamed: Q94.1 (G), Q96.3 (D), R161.1
unnamed: Q100.3 (D), R170.2
unnamed: Q100.1 (G), U50.6 (OUT)
unnamed: Q101.1 (G), Q103.3 (D), R175.1
unnamed: Q102.1 (G), Q104.3 (D), R176.1
unnamed: Q107.1 (G), Q109.3 (D), R181.1
unnamed: Q108.1 (G), Q110.3 (D), R182.1
unnamed: Q114.3 (D), R47.1, R48.1
unnamed: Q15.1 (G), Q114.1 (G), R43.1, R188.2, U10.7
unnamed: Q115.3 (D), R68.1, R69.1
unnamed: Q29.1 (G), Q115.1 (G), R64.1, R189.2, U17.7
unnamed: Q116.3 (D), R89.1, R90.1
unnamed: Q43.1 (G), Q116.1 (G), R85.1, R190.2, U24.7
unnamed: Q117.3 (D), R110.1, R111.1
unnamed: Q57.1 (G), Q117.1 (G), R106.1, R191.2, U31.7
unnamed: Q118.3 (D), R131.1, R132.1
unnamed: Q71.1 (G), Q118.1 (G), R127.1, R192.2, U38.7
unnamed: Q119.3 (D), R152.1, R153.1
unnamed: Q85.1 (G), Q119.1 (G), R148.1, R193.2, U45.7
unnamed: Q120.3 (D), R173.1, R174.1
unnamed: Q99.1 (G), Q120.1 (G), R169.1, R194.2, U52.7
unnamed: R45.2, R46.1, U10.1
unnamed: R66.2, R67.1, U17.1
unnamed: R87.2, R88.1, U24.1
unnamed: R108.2, R109.1, U31.1
unnamed: R129.2, R130.1, U38.1
unnamed: R150.2, R151.1, U45.1
unnamed: R171.2, R172.1, U52.1
unnamed: R42.2, U8.3 (SET)
unnamed: R45.1, U10.3 (+), U11.12 (P0W)
unnamed: R188.1, R196.1, R204.2, U10.5 (+)
unnamed: C17.2, R46.2, U10.6 (-)
unnamed: R40.1, R41.1, U11.10 (P1A)
unnamed: U8.1 (IN), U11.9 (P1W)
unnamed: R66.1, U12.12 (P0W), U17.3 (+)
unnamed: R61.1, R62.1, U12.10 (P1A)
unnamed: U12.9 (P1W), U15.1 (IN)
unnamed: R63.2, U15.3 (SET)
unnamed: R189.1, R197.1, R205.2, U17.5 (+)
unnamed: C25.2, R67.2, U17.6 (-)
unnamed: R87.1, U18.12 (P0W), U24.3 (+)
unnamed: R82.1, R83.1, U18.10 (P1A)
unnamed: U18.9 (P1W), U22.1 (IN)
unnamed: R108.1, U19.12 (P0W), U31.3 (+)
unnamed: R103.1, R104.1, U19.10 (P1A)
unnamed: U19.9 (P1W), U29.1 (IN)
unnamed: R84.2, U22.3 (SET)
unnamed: R190.1, R198.1, R206.2, U24.5 (+)
unnamed: C33.2, R88.2, U24.6 (-)
unnamed: R129.1, U25.12 (P0W), U38.3 (+)
unnamed: R124.1, R125.1, U25.10 (P1A)
unnamed: U25.9 (P1W), U36.1 (IN)
unnamed: R150.1, U26.12 (P0W), U45.3 (+)
unnamed: R145.1, R146.1, U26.10 (P1A)
unnamed: U26.9 (P1W), U43.1 (IN)
unnamed: R105.2, U29.3 (SET)
unnamed: R191.1, R199.1, R207.2, U31.5 (+)
unnamed: C41.2, R109.2, U31.6 (-)
unnamed: R171.1, U32.12 (P0W), U52.3 (+)
unnamed: R166.1, R167.1, U32.10 (P1A)
unnamed: U32.9 (P1W), U50.1 (IN)
unnamed: R126.2, U36.3 (SET)
unnamed: R192.1, R200.1, R208.2, U38.5 (+)
unnamed: C49.2, R130.2, U38.6 (-)
unnamed: R147.2, U43.3 (SET)
unnamed: R193.1, R201.1, R209.2, U45.5 (+)
unnamed: C57.2, R151.2, U45.6 (-)
unnamed: R168.2, U50.3 (SET)
unnamed: R194.1, R202.1, R210.2, U52.5 (+)
unnamed: C65.2, R172.2, U52.6 (-)

Notes on the sheet:
comparator with hysteresis
Connector
output with overcurrent protection
C_{mem}
PWM generator
discharge transistor
unused
weights
summation point for synaptic input currents
indicator LED
RC delay circuit determines spike duration
variable spiking threshold
Axon
variable leak resistor PWM controlled
inhibitory
Synapses
excitatory
U_{F}=2.3V

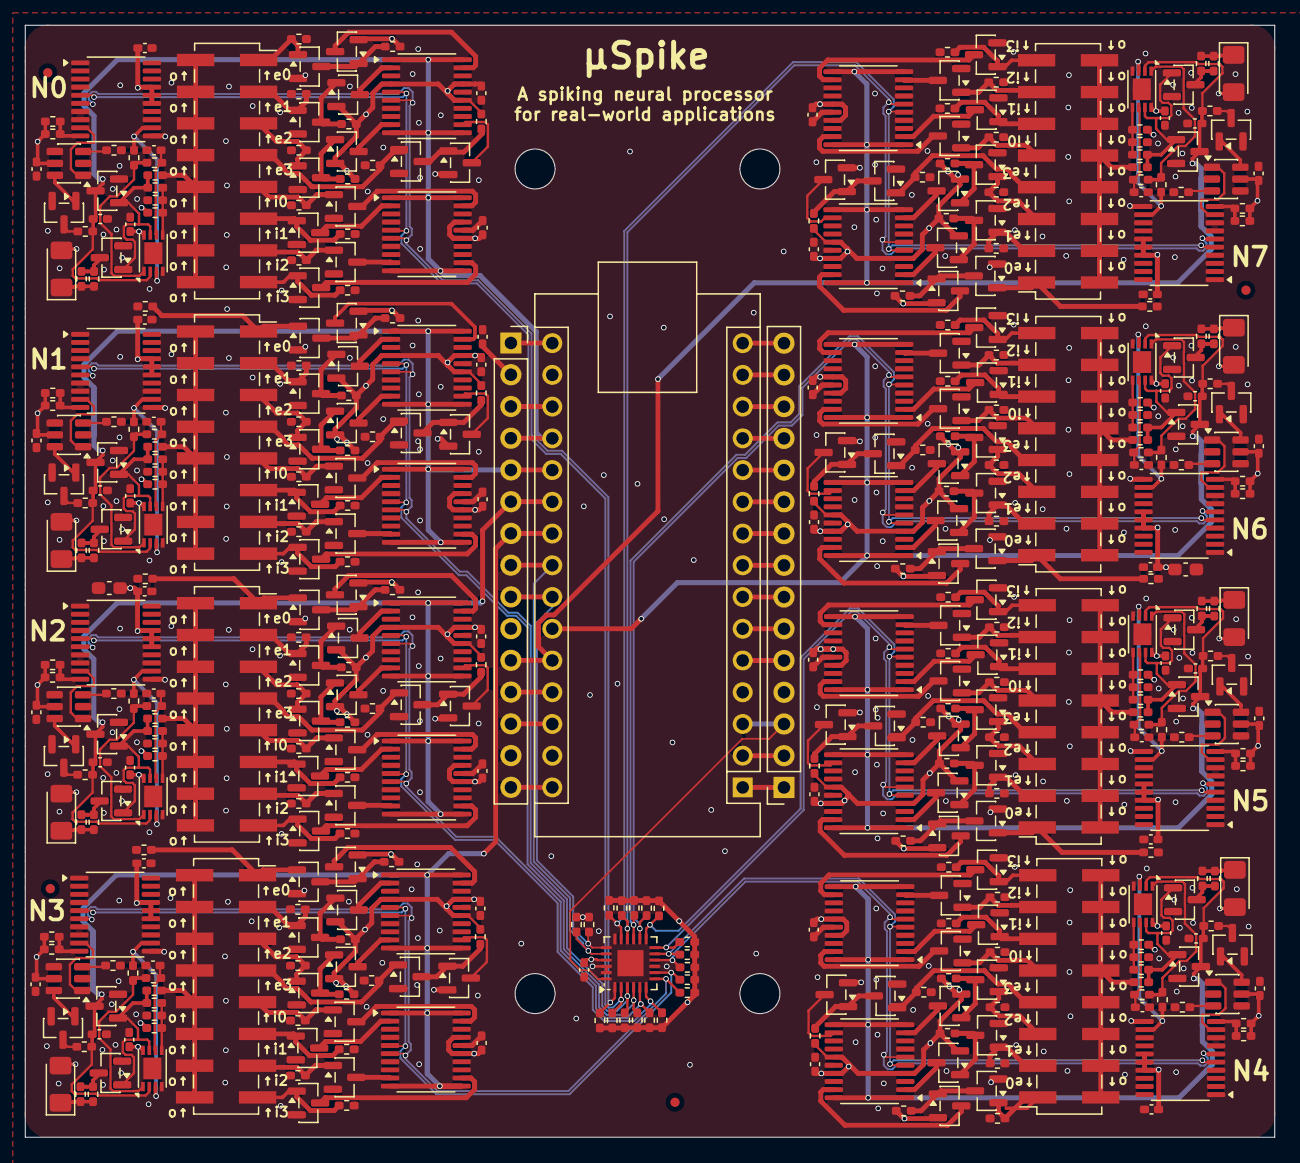
[picture p3: board SpikingNeuron.kicad_pcb from above]

Board: 4 copper layers, 100.0 x 89.0 mm, 458 parts (0 on the bottom side), 311 nets.
